ananantony/flora_mate/README.md

```
FloraMate
├─ 📁.mypy_cache
│  ├─ 📁3.14
│  │  ├─ 📁collections
│  │  │  ├─ 📄abc.data.json
│  │  │  ├─ 📄abc.meta.json
│  │  │  ├─ 📄__init__.data.json
│  │  │  └─ 📄__init__.meta.json
│  │  ├─ 📁email
│  │  │  ├─ 📄charset.data.json
│  │  │  ├─ 📄charset.meta.json
│  │  │  ├─ 📄contentmanager.data.json
│  │  │  ├─ 📄contentmanager.meta.json
│  │  │  ├─ 📄errors.data.json
│  │  │  ├─ 📄errors.meta.json
│  │  │  ├─ 📄header.data.json
│  │  │  ├─ 📄header.meta.json
│  │  │  ├─ 📄message.data.json
│  │  │  ├─ 📄message.meta.json
│  │  │  ├─ 📄policy.data.json
│  │  │  ├─ 📄policy.meta.json
│  │  │  ├─ 📄_policybase.data.json
│  │  │  ├─ 📄_policybase.meta.json
│  │  │  ├─ 📄__init__.data.json
│  │  │  └─ 📄__init__.meta.json
│  │  ├─ 📁importlib
│  │  │  ├─ 📁metadata
│  │  │  │  ├─ 📄_meta.data.json
│  │  │  │  ├─ 📄_meta.meta.json
│  │  │  │  ├─ 📄__init__.data.json
│  │  │  │  └─ 📄__init__.meta.json
│  │  │  ├─ 📁resources
│  │  │  │  ├─ 📄abc.data.json
│  │  │  │  ├─ 📄abc.meta.json
│  │  │  │  ├─ 📄_common.data.json
│  │  │  │  ├─ 📄_common.meta.json
│  │  │  │  ├─ 📄_functional.data.json
│  │  │  │  ├─ 📄_functional.meta.json
│  │  │  │  ├─ 📄__init__.data.json
│  │  │  │  └─ 📄__init__.meta.json
│  │  │  ├─ 📄abc.data.json
│  │  │  ├─ 📄abc.meta.json
│  │  │  ├─ 📄machinery.data.json
│  │  │  ├─ 📄machinery.meta.json
│  │  │  ├─ 📄readers.data.json
│  │  │  ├─ 📄readers.meta.json
│  │  │  ├─ 📄_abc.data.json
│  │  │  ├─ 📄_abc.meta.json
│  │  │  ├─ 📄_bootstrap.data.json
│  │  │  ├─ 📄_bootstrap.meta.json
│  │  │  ├─ 📄_bootstrap_external.data.json
│  │  │  ├─ 📄_bootstrap_external.meta.json
│  │  │  ├─ 📄__init__.data.json
│  │  │  └─ 📄__init__.meta.json
│  │  ├─ 📁json
│  │  │  ├─ 📄decoder.data.json
│  │  │  ├─ 📄decoder.meta.json
│  │  │  ├─ 📄encoder.data.json
│  │  │  ├─ 📄encoder.meta.json
│  │  │  ├─ 📄__init__.data.json
│  │  │  └─ 📄__init__.meta.json
│  │  ├─ 📁os
│  │  │  ├─ 📄path.data.json
│  │  │  ├─ 📄path.meta.json
│  │  │  ├─ 📄__init__.data.json
│  │  │  └─ 📄__init__.meta.json
│  │  ├─ 📁sys
│  │  │  ├─ 📄_monitoring.data.json
│  │  │  ├─ 📄_monitoring.meta.json
│  │  │  ├─ 📄__init__.data.json
│  │  │  └─ 📄__init__.meta.json
│  │  ├─ 📁zipfile
│  │  │  ├─ 📁_path
│  │  │  │  ├─ 📄__init__.data.json
│  │  │  │  └─ 📄__init__.meta.json
│  │  │  ├─ 📄__init__.data.json
│  │  │  └─ 📄__init__.meta.json
│  │  ├─ 📁_typeshed
│  │  │  ├─ 📄importlib.data.json
│  │  │  ├─ 📄importlib.meta.json
│  │  │  ├─ 📄__init__.data.json
│  │  │  └─ 📄__init__.meta.json
│  │  ├─ 📄@plugins_snapshot.json
│  │  ├─ 📄abc.data.json
│  │  ├─ 📄abc.meta.json
│  │  ├─ 📄ast.data.json
│  │  ├─ 📄ast.meta.json
│  │  ├─ 📄builtins.data.json
│  │  ├─ 📄builtins.meta.json
│  │  ├─ 📄codecs.data.json
│  │  ├─ 📄codecs.meta.json
│  │  ├─ 📄contextlib.data.json
│  │  ├─ 📄contextlib.meta.json
│  │  ├─ 📄dataclasses.data.json
│  │  ├─ 📄dataclasses.meta.json
│  │  ├─ 📄enum.data.json
│  │  ├─ 📄enum.meta.json
│  │  ├─ 📄fix_menu2.data.json
│  │  ├─ 📄fix_menu2.meta.json
│  │  ├─ 📄fix_menu_comments.data.json
│  │  ├─ 📄fix_menu_comments.meta.json
│  │  ├─ 📄genericpath.data.json
│  │  ├─ 📄genericpath.meta.json
│  │  ├─ 📄gen_kicad_footprint.data.json
│  │  ├─ 📄gen_kicad_footprint.meta.json
│  │  ├─ 📄gen_lceda_footprint.data.json
│  │  ├─ 📄gen_lceda_footprint.meta.json
│  │  ├─ 📄io.data.json
│  │  ├─ 📄io.meta.json
│  │  ├─ 📄ntpath.data.json
│  │  ├─ 📄ntpath.meta.json
│  │  ├─ 📄pathlib.data.json
│  │  ├─ 📄pathlib.meta.json
│  │  ├─ 📄posixpath.data.json
│  │  ├─ 📄posixpath.meta.json
│  │  ├─ 📄re.data.json
│  │  ├─ 📄re.meta.json
│  │  ├─ 📄sre_compile.data.json
│  │  ├─ 📄sre_compile.meta.json
│  │  ├─ 📄sre_constants.data.json
│  │  ├─ 📄sre_constants.meta.json
│  │  ├─ 📄sre_parse.data.json
│  │  ├─ 📄sre_parse.meta.json
│  │  ├─ 📄subprocess.data.json
│  │  ├─ 📄subprocess.meta.json
│  │  ├─ 📄types.data.json
│  │  ├─ 📄types.meta.json
│  │  ├─ 📄typing.data.json
│  │  ├─ 📄typing.meta.json
│  │  ├─ 📄typing_extensions.data.json
│  │  ├─ 📄typing_extensions.meta.json
│  │  ├─ 📄warnings.data.json
│  │  ├─ 📄warnings.meta.json
│  │  ├─ 📄_ast.data.json
│  │  ├─ 📄_ast.meta.json
│  │  ├─ 📄_codecs.data.json
│  │  ├─ 📄_codecs.meta.json
│  │  ├─ 📄_collections_abc.data.json
│  │  ├─ 📄_collections_abc.meta.json
│  │  ├─ 📄_frozen_importlib.data.json
│  │  ├─ 📄_frozen_importlib.meta.json
│  │  ├─ 📄_frozen_importlib_external.data.json
│  │  ├─ 📄_frozen_importlib_external.meta.json
│  │  ├─ 📄_io.data.json
│  │  ├─ 📄_io.meta.json
│  │  ├─ 📄_sitebuiltins.data.json
│  │  ├─ 📄_sitebuiltins.meta.json
│  │  ├─ 📄_tmp_write_doc.data.json
│  │  ├─ 📄_tmp_write_doc.meta.json
│  │  ├─ 📄_warnings.data.json
│  │  ├─ 📄_warnings.meta.json
│  │  ├─ 📄_winapi.data.json
│  │  ├─ 📄_winapi.meta.json
│  │  ├─ 📄_write_main_fsm.data.json
│  │  └─ 📄_write_main_fsm.meta.json
│  ├─ 📄.gitignore
│  └─ 📄CACHEDIR.TAG
├─ 📁.vscode
│  ├─ 📄launch.json
│  └─ 📄settings.json
├─ 📁code
│  ├─ 📁.settings
│  │  ├─ 📄language.settings.xml
│  │  ├─ 📄org.eclipse.core.resources.prefs
│  │  └─ 📄stm32cubeide.project.prefs
│  ├─ 📁.vscode
│  │  ├─ 📄c_cpp_properties.json
│  │  ├─ 📄launch.json
│  │  ├─ 📄settings.json
│  │  └─ 📄tasks.json
│  ├─ 📁App
│  │  ├─ 📁config
│  │  │  ├─ 📄app_config.c
│  │  │  └─ 📄app_config.h
│  │  ├─ 📁display
│  │  │  ├─ 📄app_display.c
│  │  │  └─ 📄app_display.h
│  │  ├─ 📁event
│  │  │  ├─ 📄app_event.c
│  │  │  └─ 📄app_event.h
│  │  ├─ 📁init
│  │  │  ├─ 📄app_init.c
│  │  │  └─ 📄app_init.h
│  │  ├─ 📁log
│  │  │  ├─ 📄app_log.c
│  │  │  ├─ 📄app_log.h
│  │  │  ├─ 📄app_log_ring_buffer.c
│  │  │  ├─ 📄app_log_ring_buffer.h
│  │  │  └─ 📄app_log_types.h
│  │  ├─ 📁main_fsm
│  │  │  ├─ 📄app_main_fsm.c
│  │  │  └─ 📄app_main_fsm.h
│  │  ├─ 📁manual_key
│  │  │  ├─ 📄app_manual_key.c
│  │  │  └─ 📄app_manual_key.h
│  │  ├─ 📁manual_select
│  │  │  ├─ 📄app_manual_select.c
│  │  │  └─ 📄app_manual_select.h
│  │  ├─ 📁menu
│  │  │  ├─ 📄app_menu.c
│  │  │  └─ 📄app_menu.h
│  │  ├─ 📁pump_fsm
│  │  │  ├─ 📄app_pump_fsm.c
│  │  │  └─ 📄app_pump_fsm.h
│  │  └─ 📁serial_debug
│  │     ├─ 📄app_serial_debug.c
│  │     ├─ 📄app_serial_debug.h
│  │     └─ 📄app_serial_debug_config.h
│  ├─ 📁Bsp
│  │  ├─ 📁eeprom
│  │  │  ├─ 📄bsp_eeprom.c
│  │  │  └─ 📄bsp_eeprom.h
│  │  ├─ 📁key
│  │  │  ├─ 📄bsp_key.c
│  │  │  └─ 📄bsp_key.h
│  │  ├─ 📁oled
│  │  │  ├─ 📄bsp_oled.c
│  │  │  ├─ 📄bsp_oled.h
│  │  │  ├─ 📄bsp_oled_config.h
│  │  │  └─ 📄bsp_oled_font.h
│  │  ├─ 📁pump_pwm
│  │  │  ├─ 📄bsp_pump_pwm.c
│  │  │  └─ 📄bsp_pump_pwm.h
│  │  ├─ 📁relay
│  │  │  ├─ 📄bsp_relay.c
│  │  │  └─ 📄bsp_relay.h
│  │  ├─ 📁tick
│  │  │  ├─ 📄bsp_tick.c
│  │  │  └─ 📄bsp_tick.h
│  │  ├─ 📁usart
│  │  │  ├─ 📄bsp_usart_log.c
│  │  │  └─ 📄bsp_usart_log.h
│  │  └─ 📁valve
│  │     ├─ 📄bsp_valve.c
│  │     └─ 📄bsp_valve.h
│  ├─ 📁build
│  ├─ 📁cmake
│  │  ├─ 📁stm32cubemx
│  │  │  └─ 📄CMakeLists.txt
│  │  ├─ 📄gcc-arm-none-eabi.cmake
│  │  └─ 📄starm-clang.cmake
│  ├─ 📁Common
│  │  ├─ 📁crc16
│  │  │  ├─ 📄crc16.c
│  │  │  └─ 📄crc16.h
│  │  ├─ 📁ring_buffer
│  │  │  ├─ 📄ring_buffer.c
│  │  │  └─ 📄ring_buffer.h
│  │  └─ 📁types
│  │     └─ 📄floramate_types.h
│  ├─ 📁Core
│  │  ├─ 📁Inc
│  │  │  ├─ 📄gpio.h
│  │  │  ├─ 📄i2c.h
│  │  │  ├─ 📄main.h
│  │  │  ├─ 📄stm32f4xx_hal_conf.h
│  │  │  ├─ 📄stm32f4xx_it.h
│  │  │  ├─ 📄tim.h
│  │  │  └─ 📄usart.h
│  │  ├─ 📁Src
│  │  │  ├─ 📄gpio.c
│  │  │  ├─ 📄i2c.c
│  │  │  ├─ 📄main.c
│  │  │  ├─ 📄stm32f4xx_hal_msp.c
│  │  │  ├─ 📄stm32f4xx_it.c
│  │  │  ├─ 📄syscalls.c
│  │  │  ├─ 📄sysmem.c
│  │  │  ├─ 📄system_stm32f4xx.c
│  │  │  ├─ 📄tim.c
│  │  │  └─ 📄usart.c
│  │  └─ 📁Startup
│  │     └─ 📄startup_stm32f401rctx.s
│  ├─ 📁Debug
│  ├─ 📁Drivers
│  │  ├─ 📁CMSIS
│  │  │  ├─ 📁Device
│  │  │  │  └─ 📁ST
│  │  │  │     └─ 📁STM32F4xx
│  │  │  │        ├─ 📁Include
│  │  │  │        │  ├─ 📄stm32f401xc.h
│  │  │  │        │  ├─ 📄stm32f4xx.h
│  │  │  │        │  └─ 📄system_stm32f4xx.h
│  │  │  │        ├─ 📁Source
│  │  │  │        │  └─ 📁Templates
│  │  │  │        └─ 📄LICENSE.txt
│  │  │  ├─ 📁Include
│  │  │  │  ├─ 📄cachel1_armv7.h
│  │  │  │  ├─ 📄cmsis_armcc.h
│  │  │  │  ├─ 📄cmsis_armclang.h
│  │  │  │  ├─ 📄cmsis_armclang_ltm.h
│  │  │  │  ├─ 📄cmsis_compiler.h
│  │  │  │  ├─ 📄cmsis_gcc.h
│  │  │  │  ├─ 📄cmsis_iccarm.h
│  │  │  │  ├─ 📄cmsis_version.h
│  │  │  │  ├─ 📄core_armv81mml.h
│  │  │  │  ├─ 📄core_armv8mbl.h
│  │  │  │  ├─ 📄core_armv8mml.h
│  │  │  │  ├─ 📄core_cm0.h
│  │  │  │  ├─ 📄core_cm0plus.h
│  │  │  │  ├─ 📄core_cm1.h
│  │  │  │  ├─ 📄core_cm23.h
│  │  │  │  ├─ 📄core_cm3.h
│  │  │  │  ├─ 📄core_cm33.h
│  │  │  │  ├─ 📄core_cm35p.h
│  │  │  │  ├─ 📄core_cm4.h
│  │  │  │  ├─ 📄core_cm55.h
│  │  │  │  ├─ 📄core_cm7.h
│  │  │  │  ├─ 📄core_cm85.h
│  │  │  │  ├─ 📄core_sc000.h
│  │  │  │  ├─ 📄core_sc300.h
│  │  │  │  ├─ 📄core_starmc1.h
│  │  │  │  ├─ 📄mpu_armv7.h
│  │  │  │  ├─ 📄mpu_armv8.h
│  │  │  │  ├─ 📄pac_armv81.h
│  │  │  │  ├─ 📄pmu_armv8.h
│  │  │  │  └─ 📄tz_context.h
│  │  │  └─ 📄LICENSE.txt
│  │  └─ 📁STM32F4xx_HAL_Driver
│  │     ├─ 📁Inc
│  │     │  ├─ 📁Legacy
│  │     │  │  └─ 📄stm32_hal_legacy.h
│  │     │  ├─ 📄stm32f4xx_hal.h
│  │     │  ├─ 📄stm32f4xx_hal_cortex.h
│  │     │  ├─ 📄stm32f4xx_hal_def.h
│  │     │  ├─ 📄stm32f4xx_hal_dma.h
│  │     │  ├─ 📄stm32f4xx_hal_dma_ex.h
│  │     │  ├─ 📄stm32f4xx_hal_exti.h
│  │     │  ├─ 📄stm32f4xx_hal_flash.h
│  │     │  ├─ 📄stm32f4xx_hal_flash_ex.h
│  │     │  ├─ 📄stm32f4xx_hal_flash_ramfunc.h
│  │     │  ├─ 📄stm32f4xx_hal_gpio.h
│  │     │  ├─ 📄stm32f4xx_hal_gpio_ex.h
│  │     │  ├─ 📄stm32f4xx_hal_i2c.h
│  │     │  ├─ 📄stm32f4xx_hal_i2c_ex.h
│  │     │  ├─ 📄stm32f4xx_hal_pwr.h
│  │     │  ├─ 📄stm32f4xx_hal_pwr_ex.h
│  │     │  ├─ 📄stm32f4xx_hal_rcc.h
│  │     │  ├─ 📄stm32f4xx_hal_rcc_ex.h
│  │     │  ├─ 📄stm32f4xx_hal_tim.h
│  │     │  ├─ 📄stm32f4xx_hal_tim_ex.h
│  │     │  ├─ 📄stm32f4xx_hal_uart.h
│  │     │  ├─ 📄stm32f4xx_ll_bus.h
│  │     │  ├─ 📄stm32f4xx_ll_cortex.h
│  │     │  ├─ 📄stm32f4xx_ll_dma.h
│  │     │  ├─ 📄stm32f4xx_ll_exti.h
│  │     │  ├─ 📄stm32f4xx_ll_gpio.h
│  │     │  ├─ 📄stm32f4xx_ll_i2c.h
│  │     │  ├─ 📄stm32f4xx_ll_pwr.h
│  │     │  ├─ 📄stm32f4xx_ll_rcc.h
│  │     │  ├─ 📄stm32f4xx_ll_system.h
│  │     │  ├─ 📄stm32f4xx_ll_tim.h
│  │     │  ├─ 📄stm32f4xx_ll_usart.h
│  │     │  └─ 📄stm32f4xx_ll_utils.h
│  │     ├─ 📁Src
│  │     │  ├─ 📄stm32f4xx_hal.c
│  │     │  ├─ 📄stm32f4xx_hal_cortex.c
│  │     │  ├─ 📄stm32f4xx_hal_dma.c
│  │     │  ├─ 📄stm32f4xx_hal_dma_ex.c
│  │     │  ├─ 📄stm32f4xx_hal_exti.c
│  │     │  ├─ 📄stm32f4xx_hal_flash.c
│  │     │  ├─ 📄stm32f4xx_hal_flash_ex.c
│  │     │  ├─ 📄stm32f4xx_hal_flash_ramfunc.c
│  │     │  ├─ 📄stm32f4xx_hal_gpio.c
│  │     │  ├─ 📄stm32f4xx_hal_i2c.c
│  │     │  ├─ 📄stm32f4xx_hal_i2c_ex.c
│  │     │  ├─ 📄stm32f4xx_hal_pwr.c
│  │     │  ├─ 📄stm32f4xx_hal_pwr_ex.c
│  │     │  ├─ 📄stm32f4xx_hal_rcc.c
│  │     │  ├─ 📄stm32f4xx_hal_rcc_ex.c
│  │     │  ├─ 📄stm32f4xx_hal_tim.c
│  │     │  ├─ 📄stm32f4xx_hal_tim_ex.c
│  │     │  └─ 📄stm32f4xx_hal_uart.c
│  │     └─ 📄LICENSE.txt
│  ├─ 📄.cproject
│  ├─ 📄.mxproject
│  ├─ 📄.project
│  ├─ 📄CMakeLists.txt
│  ├─ 📄CMakePresets.json
│  ├─ 📄FloraMate.ioc
│  ├─ 📄startup_stm32f401xc.s
│  ├─ 📄STM32F401RCTX_FLASH.ld
│  └─ 📄STM32F401XX_FLASH.ld
├─ 📁doc
│  ├─ 📁image
│  │  └─ 📁top板硬件设计方案
│  ├─ 📄FloraMate_V1.0_开发状态与测试指南.md
│  ├─ 📄STM32CubeMX_配置表_V1.0.md
│  ├─ 📄STM32CubeMX_配置表_V2.0_top板.md
│  ├─ 📄STM32_嵌入式_C语言编码风格手册.md
│  ├─ 📄top板硬件设计方案.md
│  ├─ 📄上电运行分支与操作逻辑_V1.1.md
│  ├─ 📄串口调试指令说明_V1.0.md
│  ├─ 📄总体设计书_V1.2.md
│  ├─ 📄硬件设计方案_V3.0.md
│  ├─ 📄软件设计方案_V1.0.md
│  └─ 📄配置项与存储映射_V1.0.md
├─ 📁file
│  ├─ 📁原理图
│  │  ├─ 📁_preview
│  │  │  ├─ 📄i2c2_full.png
│  │  │  ├─ 📄i2c2_pins_verify.png
│  │  │  ├─ 📄i2c_right.png
│  │  │  ├─ 📄keys_mcu.png
│  │  │  ├─ 📄led.png
│  │  │  ├─ 📄left_cmd.png
│  │  │  ├─ 📄mcu_full.png
│  │  │  ├─ 📄pb_pins.png
│  │  │  └─ 📄u1_i2c.png
│  │  └─ 📄SCH_Schematic1_2026-08-25.pdf
│  ├─ 📁存储
│  │  ├─ 📄bea42f4d4459f7d05e09dc1cf551c215.png
│  │  ├─ 📄型号.txt
│  │  └─ 📄存储模块.pdf
│  ├─ 📁屏幕
│  │  ├─ 📁1.3寸OLED裸屏资料
│  │  │  ├─ 📄SH1106 V2.3.pdf
│  │  │  └─ 📄SPEC QG-2864KSWLG01 VER A.pdf
│  │  └─ 📄README.md
│  ├─ 📁屏幕和按键
│  │  └─ 📁0.96寸OLED+4个按键-资料
│  │     └─ 📁0.96寸OLED+4个按键-资料
│  │        └─ 📁程序
│  │           └─ 📁（02）STM32例程(STM32F103C8T6)
│  │              └─ 📁I2C_SSD1306_STM32(HW)
│  │                 ├─ 📁Output
│  │                 └─ 📁Project
│  │                    └─ 📁RVMDK(uV4)
│  ├─ 📁按键
│  │  └─ 📄6932d3898fc3f6578d4f2fed5f337dba.jpg
│  ├─ 📁控制器
│  │  ├─ 📁STM32F4x1数据手册
│  │  │  └─ 📁STM32F4x1数据手册
│  │  │     ├─ 📄DS9716_STM32F401xB和STM32F401xC datasheet单片机的数据手册.pdf
│  │  │     ├─ 📄RM0368_STM32F401xBC和STM32F401xDE Reference manual单片机参考手册.pdf
│  │  │     └─ 📄STM32F401RCT6_DATASHEET.pdf
│  │  ├─ 📁STM32F4x1核心板-封装尺寸结构图
│  │  │  └─ 📁STM32F4x1核心板-封装尺寸结构图
│  │  │     ├─ 📁__Previews
│  │  │     │  ├─ 📄STM32F401RCT6开发板-尺寸图.pcbdocPreview
│  │  │     │  └─ 📄STM32F4x1-尺寸图.PcbDocPreview
│  │  │     ├─ 📄STM32F401RCT6开发板-尺寸图.jpg
│  │  │     └─ 📄STM32F401RCT6开发板-尺寸图.pcbdoc
│  │  ├─ 📄STM32F401RCT6开发板-原理图.pdf
│  │  ├─ 📄STM32F401RCT6开发板引脚分配.pdf
│  │  ├─ 📄STM32F4x1数据手册.rar
│  │  └─ 📄STM32F4x1核心板-封装尺寸结构图.rar
│  ├─ 📁电磁阀
│  │  └─ 📄b7ab4d8e5c5d89b31135ef5318c395e3.jpg
│  ├─ 📁继电器
│  │  ├─ 📄1431bfeb1a24a31f9118de0c2538e350.jpg
│  │  └─ 📄参数.txt
│  ├─ 📁调速
│  │  ├─ 📄36328bdf4b52b8c419efc9c0c6e27270.png
│  │  └─ 📄型号.txt
│  ├─ 📄FloraMate.pdf
│  ├─ 📄FloraMate_PCB.pdf
│  └─ 📄STM32F401RCT6开发板-尺寸图.jpg
├─ 📄.clang-format
├─ 📄.gitattributes
└─ 📄.gitignore
```
