ananantony/flora_mate/doc/FloraMate_V1.0_开发状态与测试指南.md

# FloraMate V1.0 — 开发状态与测试实践指南

> 文档版本：1.1.0 · 日期：2026-09-10 · 作者：tonymeng  
> **HMI V2.0 更新（2026-09-10）：** 产品路径已改为 Logo → Idle → 主界面 / 自动浇水。操作与手测清单以 [`上电运行分支与操作逻辑_V2.0.md`](上电运行分支与操作逻辑_V2.0.md) 为准；下文 §2~§4 部分描述仍为 V1.0 架构，已标注差异处。

---

## 一、整体架构速览

```
┌─────────────────────────────────────────────────────────────┐
│ App 层（业务逻辑）                                            │
│  app_init  app_main_fsm  app_pump_fsm  app_menu             │
│  app_display  app_config  app_event  app_log                │
├─────────────────────────────────────────────────────────────┤
│ BSP 层（板级抽象）                                            │
│  bsp_tick  bsp_usart_log  bsp_valve  bsp_pump_pwm           │
│  bsp_key   bsp_oled       bsp_eeprom                        │
├─────────────────────────────────────────────────────────────┤
│ Common（公共库）                                              │
│  ring_buffer   crc16   floramate_types                      │
├─────────────────────────────────────────────────────────────┤
│ HAL / CMSIS（STM32CubeMX 生成，不手动修改）                   │
└─────────────────────────────────────────────────────────────┘
```

MCU：STM32F401RCT6 @ 84 MHz，256 KB Flash，64 KB SRAM，LQFP64

---

## 二、已开发完成功能清单

### 2.1 BSP 层

| 模块 | 文件 | 实现内容 | 状态 |
|---|---|---|---|
| **时基** | `bsp_tick.c/h` | SysTick 1 ms 基准；`GetMs` / `ElapsedMs` / `DelayMs` | ✅ 完成 |
| **USART 日志** | `bsp_usart_log.c/h` | USART1 115200 8N1；非阻塞环形缓冲 TX；`TxFlush` 中断推进 | ✅ 完成 |
| **阀门** | `bsp_valve.c/h` | 5 路阀 Z1~Z5（PA1~PA5）AO4407A P-MOS 高边，高电平有效；干转互锁判定 `AnyOn`；逐路自检 | ✅ 完成 |
| **水泵 PWM** | `bsp_pump_pwm.c/h` | TIM2-CH1（PA0）100 Hz，1000 级分辨率；`SetDutyPercent` / `Stop`；duty>0 需任一阀已开 | ✅ 完成 |
| **按键** | `bsp_key.c/h` | 4 键（**Top V2.0：K1~K4 = PC0~PC3**）消抖 20 ms；短按 / 长按 / 超长按阈值可配；事件回调注入 | ✅ 完成 |
| **OLED** | `bsp_oled.c/h` + `bsp_oled_font.h` | 1.3" 128×64 SSD1306/1315 I2C；6×8 + 16×16 字模 | ✅ 完成 |
| **EEPROM** | `bsp_eeprom.c/h` | AT24C08C I2C（1 KB，16 B/页）；字节 / 页随机读写；在线探测 `IsOnline` | ✅ 完成 |

### 2.2 Common 层

| 模块 | 文件 | 实现内容 | 状态 |
|---|---|---|---|
| **环形缓冲** | `ring_buffer.c/h` | 通用 FIFO，字节级读写，非线程安全（供 UART TX 使用） | ✅ 完成 |
| **CRC-16** | `crc16.c/h` | CRC-16-CCITT（多项式 0x1021，初值 0xFFFF）；`Compute` + `Update` | ✅ 完成 |
| **类型定义** | `floramate_types.h` | `Fm_ErrorCode` 错误码枚举；`Fm_ValveIndex`；版本宏；硬限常量 | ✅ 完成 |

### 2.3 App 层

| 模块 | 文件 | 实现内容 | 状态 |
|---|---|---|---|
| **日志** | `app_log.c/h` + `app_log_ring_buffer.c/h` + `app_log_types.h` | MPSC 环形缓冲；6 级过滤（FATAL–VERBOSE）；紧急模式直传；限速宏；异步 UART 消费 | ✅ 完成 |
| **事件队列** | `app_event.c/h` | 8 槽 FIFO；`PostKey` 回调（供 BSP 按键调用）；`Pop`；`APP_EVENT_KEY_*` 枚举（SHORT / LONG / HOLD） | ✅ 完成 |
| **配置存储** | `app_config.c/h` | AT24C08C 双 Bank 轮换（仅配置，日志不入 EEPROM）；Bank header + payload 各一 CRC-16；版本管理；`SetField` / `GetField` / `Dump` / `FactoryReset` | ✅ 完成 |
| **显示调度** | `app_display.c/h` | 100 ms 节流；按主 FSM 切换页面（**LOGO / IDLE / AUTO_RUN / MENU / SERIAL_DEBUG / DONE / ERROR**） | ✅ V2.0 |
| **产品菜单** | `app_menu.c/h` | **V2.0：** 主界面 2 项、设置 3 项、本地测试 3 项、参数单项保存；K1–K4 完整映射 | ✅ V2.0 |
| **主状态机** | `app_main_fsm.c/h` | **V2.0：** LOGO → IDLE(5s) → AUTO_RUN / MENU / SERIAL_DEBUG → DONE / ERROR；K4 紧急停；心跳 LED | ✅ V2.0 |
| **水泵子 FSM** | `app_pump_fsm.c/h` | 单路 9 态 FSM：IDLE → INIT → OPEN_MAIN → STEP（8 档）→ RAMP_DOWN → CLOSE_MAIN → CLOSE_VALVE → GAP → DONE / ERROR；PWM 阶梯执行 | ✅ 完成 |
| **应用装配** | `app_init.c/h` | `App_Init`（6 步顺序初始化）+ `App_Loop`（永不返回主循环） | ✅ 完成 |

---

## 三、暂未开发 / 预留功能清单

### 3.1 V1.0 代码中已有占位但逻辑未实现

| 功能 | 预留位置 | 说明 |
|---|---|---|
| **AUTO_RUN 中跳过当前路（K1）** | `app_main_fsm.c:343` | `LOG_INFO("auto run: SKIP zone (K1) -- not implemented in V1.0")` 仅记录日志 |
| **AUTO_RUN 中暂停（K2）** | `app_main_fsm.c:347` | 同上；`App_Pump_Fsm_Pause/Resume` 函数已声明但未实现实际状态挂起 |
| **单路超时软检测** | `app_main_fsm.c:244-245` | 注释说明已预留注入点，目前靠总任务超时（600 s）兜底 |
| **SLEEP 状态低功耗** | `app_main_fsm.c:287-289` | 状态机进入后永久驻留，未调用 `__WFI` / Stop 模式 |
| **菜单周期逻辑** | `app_menu.c:App_Menu_Tick` | 函数体中只有预留注释，无超时返回等实际逻辑 |
| **备用阀 Z5（PA5）** | `bsp_valve.h: BSP_VALVE_Z5` | 通道已定义并可驱动，业务层暂作备用（与 Z1~Z4 等价） |

### 3.2 V2.x 规划中的扩展功能

| 功能 | 优先级 | 说明 |
|---|---|---|
| **看门狗（IWDG）** | 高 | 错误码 `FM_ERR_020_WATCHDOG` 已占位；需在 `App_Loop` 内定期喂狗 |
| **串口命令行（CLI）** | 已完成 | `app_serial_debug`：Idle 5s 或设置→Serial Test 进调试；`AUTO_ENTER` 宏可上电直进调试 |
| **定时自动浇灌** | 中 | 需外挂 RTC（MCU 内置 RTC 或外置 DS3231）+ 配置时间表；EEPROM 预留空间足够 |
| **单路超时精细控制** | 低 | 目前靠总超时兜底；可在子 FSM Tick 内加 `per_channel_timeout_s` 判断 |
| **水流传感器** | 低 | 架构支持，硬件未焊接；可接预留 GPIO 外部中断计脉冲（注意避开已用引脚） |
| **蓝牙 / WiFi 远程** | 低 | 预留 USART2 / SPI2 外扩模块；需增加通信适配层 |
| **日志持久化** | 低 | **AT24C08C 仅 1 KB，只存配置；日志在 RAM（易失）。** 如需掉电保留历史须换更大容量存储后再规划 |

---

## 四、测试流程指南

### 4.1 硬件首次上电检查清单

```
□ 确认 3.3 V / 5 V 双电源正常，无异常发热
□ ST-Link 连接成功，STM32CubeIDE Debug 模式下单步走 App_Init 前半段
□ OLED 显示 Logo（SW/HW 版本行）→ Idle 5s 倒计时
□ USART1（PA9 TX = 115200 8N1）收到日志：
    [xxx][I][FloraMate] [App_Init,...] ==== FloraMate V1.0 ====
    [xxx][I][FloraMate] [App_Init,...] init done. eeprom=1 oled=1
    [xxx][I][FloraMate] sys fsm: init LOGO
□ Idle 期间串口每秒 `[I] hb ... wait_remain_ms=...`；进入调试后无心跳
□ Idle 发 `debug` → OLED 显示命令与 OK/ERR，串口打印 help
□ 不按键、Idle 超时后进入 AUTO_RUN 自动浇灌
□ 心跳 LED（Top 板原理图 PC12；当前 Cube 配置见 Core/Inc/main.h）~500 ms 闪烁
```

### 4.2 BSP 单模块验证

#### 4.2.1 电磁阀（P-MOS 高边）

```
测试方法：进入串口调试态（上电后发送 `debug`）
操作：`valve open 1`~`5` 逐路测 Z1~Z5（PA1~PA5）
验证：
  □ 对应阀通电出水 / 指示灯变化（LED 灭 = 阀开，LED 亮 = 阀关）
  □ 用万用表量 VALVEx_OUT_P（P-MOS 漏极）：阀开≈12V，阀关≈0V
  □ OLED 显示阀号和 ON/OFF 状态
  □ 串口无 I2C 错误日志
退出时验证全部阀 OFF（发送 `stop` 或 `valve close`）
```

#### 4.2.2 水泵 PWM

```
测试方法：进入串口调试态后用阀和泵命令联调
推荐步骤：
  1. `valve open 1`（任一路阀，满足干转互锁）
  2. `pump 30`，再按需 `pump 50` / `pump 80`（实际夹到 ≤95%）
  3. 用示波器或逻辑分析仪测量 PA0 波形：
     □ 频率 100 Hz（±1%）
     □ 占空比与 OLED 显示一致
  4. 无阀打开时发 `pump 30` 应被拒绝，返回 `FM_ERR_013_PUMP_NO_POWER`
  5. `pump off`，验证 PWM 归零（停泵）
```

#### 4.2.3 OLED

```
在 IDLE 倒计时页观察：
  □ 倒计时数字每秒递减（使用 16×16 大字模）
  □ 屏幕无撕裂 / 残影
  □ 调整菜单中的 oled_contrast 参数，保存后对比度变化
```

#### 4.2.4 按键

```
  □ LOGO / IDLE / SERIAL_DEBUG 下菜单键无效（`App_Main_Fsm_KeyInputEnabled`）
  □ `valve open 1` + `valve open 2` 可同时 on；`valve close` 全部释放
恢复菜单/自动流程后再按原 IDLE / DONE / ERROR 映射验证按键
```

#### 4.2.5 EEPROM

```
验证步骤：
  1. 进入菜单 → 参数列表，将某个参数改为非默认值（如 step_count=3）
  2. 长按 K3 保存 → 日志出现 "config saved to bank X"
  3. 断电 → 重新上电
  4. 进入菜单验证修改已持久化
  5. 工厂复位页长按 K4（3 s）确认 → 验证参数恢复默认值
  6. 串口确认 "factory reset done"
```

### 4.3 系统级端到端测试

#### 4.3.1 标准浇灌流程（V2.0 产品路径）

```
前提：至少 channel_enable bit0 = 1（Z1 开启），step_count ≥ 1，step_duty[0] > 0
步骤：
  1. 上电 → Logo → 等待 Idle 5s 倒计时结束（或 Idle 期间 K1+K3 2s 进主界面后选 Auto Water）
  2. 观察 AUTO_RUN 进度：
     □ OLED 显示 "Zone 1 / Step X / Duty Y%"
     □ 当前路阀 Z_i 先开，约 200 ms 后水泵 PWM 起调
     □ PWM 按配置阶梯输出
  3. 单路完成后观察：
     □ PWM 先 RAMP_DOWN → 停泵（PWM=0）→ 关阀 → 路间静默
     □ 继续下一路（若已使能）
  4. 全部完成后：
     □ 进入 DONE 页（"All Done!"），**K4 回主界面**
     □ 所有阀确认为 OFF 状态（万用表/目视指示灯）
```

#### 4.3.2 紧急停止测试（V2.0）

```
步骤：AUTO_RUN 进行中 → 按 K4（短按/长按均可）
验证：
  □ 日志 "auto run: STOPPED by K4"
  □ 所有阀立即 OFF（App_Pump_Fsm_Abort）
  □ 系统进入 DONE（Stopped），再按 K4 回主界面
  □ 水流在 < 500 ms 内停止（阀门响应时间）
```

#### 4.3.3 超时保护测试

```
方法：将 total_timeout_s 设置为极小值（如 5 s）
步骤：开始自动浇灌 → 不干预 → 等待 5 s
验证：
  □ 日志出现 "auto run: TOTAL timeout (5s)"
  □ 系统进入 ERROR 状态
  □ 所有阀 OFF，心跳 LED 快速闪烁（100 ms）
  □ OLED 显示错误码
```

#### 4.3.4 EEPROM 掉电安全测试

```
步骤：
  1. 开始保存配置时（长按 K3），立即断电
  2. 重新上电，观察配置是否完好
原理：双 Bank 写入先 payload 后 header；
     断在 payload 写入中途 → 该 Bank header 未更新，回退到旧 Bank；
     断在 header 写入中途 → CRC 校验失败，回退到旧 Bank。
预期：任何断电时机均不会丢失上一次成功保存的配置。
```

### 4.4 串口调试方法

连接 USART1（PA9，115200 8N1），使用 SecureCRT / MobaXterm / VSCode Serial Monitor：

```
观察启动序列（关键日志示例）：
[0][I][FloraMate] [App_Init,...] ==== FloraMate V1.0 ====
[1][I][FloraMate] [App_Config_Init,...] config loaded from bank A (seq=3)
[2][I][FloraMate] [App_Init,...] init done. eeprom=1 oled=1
[3][I][FloraMate] sys fsm: init LOGO
[I] hb uptime_ms=1000 wait_remain_ms=4000
debug
[I] serial debug active (no hb)
```

调整日志等级（菜单 log_level 参数）：
- `0` = ERROR 只看报错
- `1` = WARN  推荐日常调试
- `2` = INFO  查看状态转移（默认）
- `3` = DEBUG 查看 FSM 每步细节

常用命令见 `串口调试指令说明_V1.0.md`。最小联调序列：

```text
debug
status
valve open 1
pump 30
pump off
valve close
```

---

## 五、后续开发优先级建议

### 阶段 1（硬件验证期，本周）

```
1. 完成 § 4.1 ~ § 4.3 所有硬件验证项
2. 记录并修复实测中发现的参数不合理（阀门开合时序、PWM 阶梯时间）
3. 确认 EEPROM 双 Bank 切换正常（§ 4.2.5 + § 4.3.4）
```

### 阶段 2（功能完善，2~3 周）

```
4. 实现看门狗（IWDG）
   - App_Loop 每轮喂狗
   - 配置超时约 2 s（主循环空载 < 200 μs，有充足余量）

5. 恢复/完善自动运行入口
   - 需要长期停在调试态时，将 `APP_SERIAL_DEBUG_AUTO_ENTER_ON_BOOT` 置 1 重新编译

6. 实现单路超时精细检测
   - 在 App_Main_Fsm_Tick 的 AUTO_RUN case 内，对当前运行路
     增加 per_channel_timeout_s 判断并记录错误码
```

### 阶段 3（可选增强）

```
7. 日志持久化（需先换更大容量存储）
   - 当前 AT24C08C 仅 1 KB 且只存配置，**日志保持在 RAM（易失）**
   - 如需掉电保留历史，改用 AT24C32/64 或 SPI Flash 后再划日志区

8. RTC + 定时浇灌
   - 接入 MCU 内置 RTC（无需外接晶振，F401 内置 RC 精度够用）
   - 在 EEPROM 中增加 schedule[7] 数组（每天时刻 + 使能位）
   - App_Main_Fsm 在 SLEEP 态周期唤醒比对 RTC

9. 暂停 / 继续功能
   - App_Pump_Fsm_Pause：保存 step_idx，PWM 降为 0（停泵），保持当前阀
   - App_Pump_Fsm_Resume：恢复 PWM + 剩余时间继续
```

---

## 六、已知约束与注意事项

| 约束 | 说明 |
|---|---|
| **浇灌期间不可断电** | V1.0 无断电续浇逻辑；若中途断电，重启后会重新从第一路开始 |
| **EEPROM 寿命** | AT24C08C 典型写寿命 1,000,000 次；双 Bank + `update_count` 统计；仅低频配置写入，寿命非瓶颈 |
| **看门狗未启用** | V1.0 无 IWDG；软件死锁时需手动断电复位，**待阶段 2 修复** |
| **Idle 5s 串口窗** | Logo 后 Idle 5s 内可发 `debug`；超时自动浇水；Idle 期间 K1+K3 2s 进主界面；`AUTO_ENTER=1` 可常开调试 |
| **备用阀 Z5（PA5）** | 通道已定义并可驱动，业务层暂未编排（与 Z1~Z4 等价） |
| **K4 紧急停止** | AUTO_RUN 期间 K4 立即停止并进入 DONE(Stopped) |
| **SLEEP 已移除** | V2.0 产品路径无 SLEEP 态；完成页等待 K4 回主界面 |
| **单路最大占空比 95%** | `FM_PUMP_DUTY_MAX_PERCENT = 95`，硬限，不允许 100%（过热保护） |
| **总任务硬限 600 s** | `FM_TOTAL_TASK_HARD_LIMIT_S = 600`，代码层不允许 EEPROM 配置覆盖 |

---

*文档由 AI 辅助生成，基于代码实际实现状态；如需更新请同步修改本文件。*
