ananantony/flora_mate/doc/top板硬件设计方案.md

基于最新提交的完整原理图（图纸名称：FloraMate V1.0 / Schematic1），本方案剥离所有 PCB 走线和物理布局内容，聚焦于**电路拓扑、电气特性、信号流向、参数计算依据以及 MCU 每个引脚的具体硬件映射与功能定义**。

### **一、 电源管理与供电切换子系统**

Plaintext  
 \[Type-C USB1\] ──► 5V\_USB ──► \[BAT54C D1 Pin1 (A1)\] ┐  
                                                     ├─► 5V\_MAIN ──► \[AMS1117-3.3 U3\] ──► 3V3 主电源网  
 \[2×10Pin U1\]  ──► \+5V\_CLEAN ─► \[BAT54C D1 Pin2 (A2)\] ┘                │  
                                                                       ▼  
                                                       \[C8: 10µF \+ C9: 100nF (输入滤波)\]  
                                                       \[C10: 100nF \+ C11: 10µF (输出滤波)\]

#### **1\. 双路电源 OR-ing 无缝切换电路**

* **核心器件**：D1 (BAT54C) SOT-23 共阴极双肖特基二极管。  
* **引脚与流向**：  
  * **Pin 1 (阳极 A1)**：接入 Type-C 接口输出的 5V\_USB 节点。  
  * **Pin 2 (阳极 A2)**：接入 2×10Pin 接口 Pin 1 传入的外部净化电源 \+5V\_CLEAN。  
  * **Pin 3 (公共阴极 K)**：输出汇聚节点 5V\_MAIN。  
* **工作逻辑与电气参数**：  
  * **自动接管**：肖特基二极管正向导通压降极低（$V\_{\\text{F}} \\approx 0.32\\text{V} @ 50\\text{mA}$），两路 5V 谁电压略高即由谁自动向后级供电。  
  * **防倒灌保护**：两颗单向导电管阻断反向回路，杜绝插上 USB 调试时向外部动力板倒灌，同时防止下板动力反串损坏 PC 端 USB 接口。

#### **2\. LDO 线性稳压与阶梯式滤波电路**

* **核心器件**：U3 (AMS1117-3.3) SOT-223 封装固定输出稳压器。  
* **输入级滤波**：5V\_MAIN 进入 Pin 3 (VIN) 前，并联 **C8 (10µF MLCC)** 吸收低频纹波 \+ **C9 (100nF MLCC)** 滤除高频瞬态毛刺。  
* **输出级稳压**：Pin 2 / Pin 4 (VOUT) 输出 3V3 电平，并联 **C10 (100nF)** \+ **C11 (10µF)**。  
* **压差计算裕量**：  
  $$V\_{\\text{IN\\\_LDO}} \= 5.0\\text{V} \- V\_{\\text{F(BAT54C)}} \\approx 4.68\\text{V}$$  
  $$\\Delta V \= 4.68\\text{V} \- 3.3\\text{V} \= 1.38\\text{V} \> V\_{\\text{dropout(max)}} (1.1\\text{V})$$  
  保证 LDO 在全负载工况下均稳定工作在稳压线性区。

### **二、 USB-UART 通信与 ESD 接口子系统**

#### **1\. Type-C 受电接口（USB1）**

* **位号/型号**：USB1 (TYPE-C 16PIN 2MD/073)。  
* **CC 逻辑配置**：CC1 (Pin A5) 与 CC2 (Pin B5) 分别通过 **R22 (5.1kΩ)** 与 **R18 (5.1kΩ)** 独立下拉至 ISO\_GND。  
  * **原理**：通知供电端（Source/PC/PD充电头）本机为标准 UFP（受电下行设备），请求开启默认 5V VBUS 供电。  
* **外壳与屏蔽**：外壳固定脚（EH）直连 ISO\_GND，提供静电泄放通路。

#### **2\. 瞬态静电防护（D2: USBLC6-2SC6）**

* **拓扑结构**：  
  * **Pin 1 (I/O1)** 接 Type-C Dp1/Dp2，**Pin 6 (I/O1)** 输出 USB\_D+。  
  * **Pin 3 (I/O2)** 接 Type-C Dn1/Dn2，**Pin 4 (I/O2)** 输出 USB\_D-。  
  * **Pin 5 (VBUS)** 接 5V\_USB，**Pin 2 (GND)** 接 ISO\_GND。  
* **原理**：将 USB 数据线与电源线的超压静电尖峰双向钳位至 $V\_{\\text{BUS}} \+ V\_{\\text{F}}$ 与 $\\text{GND} \- V\_{\\text{F}}$，极低结电容（$\< 0.8\\text{pF}$）确保 USB 全速信号不失真。

#### **3\. USB 转串口芯片（U4: CH340C）**

* **供电与退耦**：  
  * Pin 16 (VCC) 接入 3V3，配置 **C17 (100nF)** 退耦电容。  
  * Pin 4 (V3) 内部 LDO 节点直接短接至 3V3（在 3.3V 供电标准下必须短接 VCC 与 V3）。  
* **信号连接**：  
  * Pin 5 (D+) 与 Pin 6 (D-) 分别接入经过 ESD 芯片后的 USB\_D+ 与 USB\_D-。  
  * Pin 2 (TXD) 输出 USART1\_RX 信号，Pin 3 (RXD) 输入 USART1\_TX 信号，直连 MCU 串口。

### **三、 人机交互、存储与板间接口子系统**

#### **1\. 硬件 RC 消抖按键电路（KEY1）**

* **接口**：5-Pin 插件端子（Pin 1 为公共 ISO\_GND，Pin 2\~5 分别为 K1\~K4 按键输入）。  
* **4 路独立对称滤波网络**（以 K1 为例）：  
  * **串联限流防冲**：K1 输入端串联 **R19 (100Ω)** 抑制机械触点打火与 ESD。  
  * **电平偏置**：节点通过 **R29 (10kΩ)** 上拉至 3V3，静态保持高电平。  
  * **硬件积分消抖**：并联 **C21 (100nF)** 到 ISO\_GND。  
  * **时间常数**：$\\tau \= R \\times C \= 10\\text{k}\\Omega \\times 100\\text{nF} \= 1\\text{ms}$，滤除按键动作产生的 $5\\sim 10\\text{ms}$ 机械弹跳毛刺。  
* **其他通道映射**：  
  * K2 $\\to$ R20 (100Ω) \+ R30 (10kΩ) \+ C22 (100nF)  
  * K3 $\\to$ R21 (100Ω) \+ R28 (10kΩ) \+ C20 (100nF)  
  * K4 $\\to$ R23 (100Ω) \+ R31 (10kΩ) \+ C23 (100nF)

#### **2\. I²C 总线拓扑与非易失存储（I2C1 域）**

* **总线上拉**：I2C1\_SCL 与 I2C1\_SDA 分别配置 **R6 (4.7kΩ)** 与 **R7 (4.7kΩ)** 上拉至 3V3。  
* **EEPROM 存储器（U10: AT24C08C）**：  
  * 供电端 Pin 8 (VCC) 配置 **C18 (100nF)** 滤波。  
  * 地址选择 Pin 1\~3 (E0, E1, E2) 与写保护 Pin 7 (WC\#) 均接地 ISO\_GND，器件固定硬件物理地址，处于全程允许读写状态。  
  * Pin 6 (SCL) 与 Pin 5 (SDA) 挂载至 I2C1 总线，用于掉电持久化保存运行参数。  
* **显示接口（OLED1）**：  
  * 4-Pin 接口直出 3V3、ISO\_GND、I2C1\_SCL、I2C1\_SDA，驱动 0.96 寸 OLED 显示屏。

#### **3\. 双板互联总线（U1: 2×10Pin 2.54mm 排针）**

用于控制信号向底层功率驱动板下发以及状态信号回传：

* **Pin 1**：+5V\_CLEAN（隔离电源输入正极）  
* **Pin 3, 5, 7, 9, 11**：VALVE1\_CMD \~ VALVE4\_CMD、PUMP\_CMD 动力驱动信号  
* **Pin 8, 10, 12**：VALVE2\_CMD、VALVE3\_CMD、VALVE5\_CMD 动力驱动信号  
* **Pin 15, 16**：I2C2\_SCL、I2C2\_SDA（隔离数字测量总线，预留给底层功率计）  
* **Pin 2, 4, 6, 13, 14, 17, 18**：多点直通 ISO\_GND，为各路控制信号提供就近的回流屏蔽

### **四、 主控 MCU（U2: STM32F401RCT6）引脚硬件级映射方案**

MCU 采用 LQFP-64 封装，工作核心主频 84MHz，内置 256KB Flash 与 64KB SRAM。下表详述当前原理图上**全部 64 个物理引脚的硬件连接、网络名称、外设复用与电气配置**：

| 引脚编号 | 引脚物理原生名称 | 原理图网络名称 (Net Name) | 外设功能映射 | 外围硬件电路详细说明 |
| :---- | :---- | :---- | :---- | :---- |
| **1** | VBAT | 3V3 | 备用电池供电 | 经 **R3 (0Ω 跳线)** 直连板载 3V3，维持内部 RTC 与后备寄存器供电。 |
| **2** | PC13-ANTI\_TAMP | PC13 | GPIO 输入 | 悬空预留，可作为低功耗侵入检测或用户备用 GPIO。 |
| **3** | PC14-OSC32\_IN | PC14 | GPIO / LSE 输入 | 悬空预留，未焊接 32.768kHz 低速晶振。 |
| **4** | PC15-OSC32\_OUT | PC15 | GPIO / LSE 输出 | 悬空预留，未焊接 32.768kHz 低速晶振。 |
| **5** | PH0-OSC\_IN | PH0-OSC\_IN | HSE 时钟输入 | 直连 25MHz 晶振 **X2** 一端，并联 **C12 (15pF C0G)** 负载电容到地。 |
| **6** | PH1-OSC\_OUT | PH1-OSC\_OUT | HSE 时钟输出 | 直连 25MHz 晶振 **X2** 另一端，并联 **C13 (15pF C0G)** 负载电容到地。 |
| **7** | NRST | NRST | 系统异步复位 | 连接 **R24 (10kΩ)** 上拉至 3.3V，并联 **C14 (100nF)** 消抖电容，引至 SWD1 排针。 |
| **8** | PC0 | PC0 | GPIO 输入 (按键) | 接入 **K1** 按键滤波输出节点（R19+R29+C21 滤波后信号）。 |
| **9** | PC1 | PC1 | GPIO 输入 (按键) | 接入 **K2** 按键滤波输出节点（R20+R30+C22 滤波后信号）。 |
| **10** | PC2 | PC2 | GPIO 输入 (按键) | 接入 **K3** 按键滤波输出节点（R21+R28+C20 滤波后信号）。 |
| **11** | PC3 | PC3 | GPIO 输入 (按键) | 接入 **K4** 按键滤波输出节点（R23+R31+C23 滤波后信号）。 |
| **12** | VSSA / VREF- | ISO\_GND | 模拟地基准 | 直连整板隔离地 ISO\_GND。 |
| **13** | VDDA / VREF+ | 3V3 | 模拟电源基准 | 直连 3V3，配置 **C7 (100nF)** 独立高频退耦电容。 |
| **14** | PA0-WKUP | PA0 | TIM2\_CH1 / GPIO | 串接 **R1 (510Ω)** 限流电阻，输出 PUMP\_CMD 水泵控制信号至 U1。 |
| **15** | PA1 | PA1 | TIM2\_CH2 / GPIO | 串接 **R2 (510Ω)** 限流电阻，输出 VALVE1\_CMD 电磁阀1控制信号至 U1。 |
| **16** | PA2 | PA2 | TIM2\_CH3 / GPIO | 串接 **R4 (510Ω)** 限流电阻，输出 VALVE2\_CMD 电磁阀2控制信号至 U1。 |
| **17** | PA3 | PA3 | TIM2\_CH4 / GPIO | 串接 **R5 (510Ω)** 限流电阻，输出 VALVE3\_CMD 电磁阀3控制信号至 U1。 |
| **18** | VSS\_1 | ISO\_GND | 数字地 1 | 芯片就地连接主地平面 ISO\_GND。 |
| **19** | VDD\_1 | 3V3 | 数字电源 1 | 接入 3V3，就近配置 **C1 (100nF)** 退耦电容。 |
| **20** | PA4 | PA4 | GPIO 输出 | 串接 **R10 (510Ω)** 限流电阻，输出 VALVE4\_CMD 电磁阀4控制信号至 U1。 |
| **21** | PA5 | PA5 | GPIO 输出 | 串接 **R11 (510Ω)** 限流电阻，输出 VALVE5\_CMD 电磁阀5控制信号至 U1。 |
| **22** | PA6 | PA6 | GPIO / ADC | 悬空预留，可配置为通用输入输出或模拟采样。 |
| **23** | PA7 | PA7 | GPIO / ADC | 悬空预留，可配置为通用输入输出或模拟采样。 |
| **24** | PC4 | PC4 | GPIO / ADC | 悬空预留。 |
| **25** | PC5 | PC5 | GPIO / ADC | 悬空预留。 |
| **26** | PB0 | PB0 | GPIO / TIM3\_CH3 | 悬空预留。 |
| **27** | PB1 | PB1 | GPIO / TIM3\_CH4 | 悬空预留。 |
| **28** | PB2 | PB2 / BOOT1 | GPIO / BOOT1 | 悬空预留，内部默认下拉。 |
| **29** | PB10 | I2C2\_SCL | I2C2\_SCL | 串接 **R13 (100Ω)** 阻抗匹配电阻，输出 I2C2\_SCL 至 U1 Pin15；挂载 **R8 (4.7kΩ)** 上拉至 3.3V。 |
| **30** | VCAP\_1 | VCAP1 | 内部 1.2V LDO 稳压输出 | 外接 **C15 (4.7µF MLCC)** 极低 ESR 储能电容到 ISO\_GND（**禁止接任何电源**）。 |
| **31** | VSS\_2 | ISO\_GND | 数字地 2 | 芯片就地连接主地平面 ISO\_GND。 |
| **32** | VDD\_2 | 3V3 | 数字电源 2 | 接入 3V3，就近配置 **C2 (100nF)** 退耦电容。 |
| **33** | PB12 | I2C2\_SDA | I2C2\_SDA | 串接 **R17 (100Ω)** 阻抗匹配电阻，输出 I2C2\_SDA 至 U1 Pin16；挂载 **R9 (4.7kΩ)** 上拉至 3.3V。 |
| **34** | PB13 | PB13 | SPI2\_SCK / GPIO | 悬空预留。 |
| **35** | PB14 | PB14 | SPI2\_MISO / GPIO | 悬空预留。 |
| **36** | PB15 | PB15 | SPI2\_MOSI / GPIO | 悬空预留。 |
| **37** | PC6 | PC6 | TIM3\_CH1 / GPIO | 悬空预留。 |
| **38** | PC7 | PC7 | TIM3\_CH2 / GPIO | 悬空预留。 |
| **39** | PC8 | PC8 | TIM3\_CH3 / GPIO | 悬空预留。 |
| **40** | PC9 | PC9 | TIM3\_CH4 / GPIO | 悬空预留。 |
| **41** | PA8 | PA8 | MCO1 / GPIO | 悬空预留，可作为主时钟输出测试点。 |
| **42** | PA9 | USART1\_TX | USART1\_TX | 串接 **R12 (1kΩ)** 保护电阻，连接至 CH340C 的 RXD (Pin 3\) 进行串口发送。 |
| **43** | PA10 | USART1\_RX | USART1\_RX | 串接 **R15 (1kΩ)** 保护电阻，连接至 CH340C 的 TXD (Pin 2\) 进行串口接收。 |
| **44** | PA11 | PA11 | USB\_DM / GPIO | 经 **R14 (10kΩ)** 下拉至 ISO\_GND（禁用 MCU 片上原生 USB 物理层）。 |
| **45** | PA12 | PA12 | USB\_DP / GPIO | 经 **R16 (10kΩ)** 下拉至 ISO\_GND（禁用 MCU 片上原生 USB 物理层）。 |
| **46** | PA13 | SWDIO | JTMS-SWDIO | 直连调试端子 **SWD1 Pin 2**，用于 SWD 双向数据烧录与调试。 |
| **47** | VSS\_3 | ISO\_GND | 数字地 3 | 芯片就地连接主地平面 ISO\_GND。 |
| **48** | VDD\_3 | 3V3 | 数字电源 3 | 接入 3V3，就近配置 **C3 (100nF)** 退耦电容。 |
| **49** | PA14 | SWCLK | JTCK-SWCLK | 直连调试端子 **SWD1 Pin 3**，用于 SWD 时钟同步。 |
| **50** | PA15 | PA15 | JTDI / GPIO | 悬空预留。 |
| **51** | PC10 | PC10 | UART4\_TX / GPIO | 悬空预留。 |
| **52** | PC11 | PC11 | UART4\_RX / GPIO | 悬空预留。 |
| **53** | PC12 | PC12 | GPIO 输出 (指示灯) | 连接 **LED1 (蓝色发光管)** 阴极，阳极经 **R20 (470Ω)** 接 3.3V，低电平点亮。（**注意**：本文档沿用功能名 LED1=PC12 心跳灯，对应原理图位号 **LED2 / R20**，阻值已由 4.7kΩ 改为 470Ω。） |
| **54** | PD2 | PD2 | TIM3\_ETR / GPIO | 悬空预留。 |
| **55** | PB3 | PB3 | JTDO / TRACESWO | 悬空预留。 |
| **56** | PB4 | PB4 | NJTRST / GPIO | 悬空预留。 |
| **57** | PB5 | PB5 | GPIO / I2C1\_SMBA | 悬空预留。 |
| **58** | PB6 | I2C1\_SCL | I2C1\_SCL | 挂载 **R6 (4.7kΩ)** 上拉至 3.3V，直连 U10 EEPROM 与 OLED1 屏幕的 SCL。 |
| **59** | PB7 | I2C1\_SDA | I2C1\_SDA | 挂载 **R7 (4.7kΩ)** 上拉至 3.3V，直连 U10 EEPROM 与 OLED1 屏幕的 SDA。 |
| **60** | BOOT0 | BOOT0 | 启动模式选择 | 经 **R25 (10kΩ)** 下拉至 ISO\_GND，锁定系统上电默认从用户 Flash 启动。 |
| **61** | PB8 | PB8 | TIM4\_CH3 / GPIO | 悬空预留。 |
| **62** | PB9 | PB9 | TIM4\_CH4 / GPIO | 悬空预留（芯片原生 I2C2\_SDA 复用脚，本板未用）。 |
| **63** | VSS\_4 | ISO\_GND | 数字地 4 | 芯片就地连接主地平面 ISO\_GND。 |
| **64** | VDD\_4 | 3V3 | 数字电源 4 | 接入 3V3，就近配置 **C4 (100nF)** 退耦电容。 |

> **⚠️ 已知硬件设计问题 — I2C2 引脚复用不匹配（按原理图网络名记录，暂不改线）**
>
> | 原理图网络 | 实际走线引脚 | 芯片 AF4 功能 | 结论 |
> |---|---|---|---|
> | I2C2_SCL | **PB10** (Pin 29) | **I2C2_SCL** | ✅ 正确，可用硬件 I2C2 SCL |
> | I2C2_SDA | **PB12** (Pin 33) | **I2C2_SMBA**（非 SDA） | ❌ 无法作为硬件 I2C2_SDA |
> | — | PB9 (Pin 62，未走线) | **I2C2_SDA** | 改板建议：SDA 改接 PB9 |
>
> 固件/CubeMX 策略：**PB10 = I2C2_SCL（硬件）**；**PB12 = GPIO 开漏软件 bit-bang SDA**（Label: `I2C2_SDA_BB`）。详见 `STM32CubeMX_配置表_V2.0_top板.md` § 6.6。
>
> **其余业务引脚复用核对（2026-08-25）**：PA0~PA5、PA9/PA10、PB6/PB7、PC0~PC3、PC12、PH0/PH1 均与 STM32F401RCT6 数据手册 AF 表一致，**无其他冲突**。

### **五、 关键阻容参数设计依据与电路保护机理**

> 1. **串口引脚隔离保护阻抗（R12, R15: 1kΩ）**：  
   * 在 MCU (PA9/PA10) 与 CH340C (RXD/TXD) 之间串入 1kΩ 电阻。  
   * **作用**：当 USB 未插电（CH340C 断电）而系统由外部供电运行时，MCU 串口引脚输出的高电平不会通过 CH340C 内部 ESD 保护二极管形成电流倒灌，避免 CH340C 处于微弱“假带电”异常悬浮状态。  
> 2. **片上 USB 物理引脚下拉锁定（R14, R16: 10kΩ）**：  
   * 将未使用的 PA11 (DM) 与 PA12 (DP) 引脚通过 10kΩ 电阻下拉接地。  
   * **作用**：防止引脚悬空在高频环境下捕获静电天线效应触发 MCU 内部 USB 外设中断或产生浮空漏电流。  
> 3. **输出控制线限流缓冲（R1, R2, R4, R5, R10, R11: 510Ω）**：  
   * 串联在 PA0\~PA5 控制输出口与 U1 端子之间。  
   * **作用**：为下层驱动板的光耦输入端发光二极管（如 TLP281）提供精准的前向工作电流限流：  
     $$I\_{\\text{F}} \= \\frac{V\_{\\text{OH}} \- V\_{\\text{F(opto)}}}{R} \= \\frac{3.3\\text{V} \- 1.2\\text{V}}{510\\Omega} \\approx 4.12\\text{mA}$$  
     既保证光耦深饱和导通，又避免单片机 GPIO 超负荷发热。  
> 4. **内部稳压电容配置（C15: 4.7µF X7R）**：  
   * 跨接在 Pin 30 ($V\_{\\text{CAP\\\_1}}$) 与地之间。  
   * **作用**：STM32F4 内部 1.2V 调压器（供电给 Cortex-M4 内核、锁相环 PLL 及数字外设）的稳定补偿电容。4.7µF 容量与极低 ESR 抑制了 PLL 高频倍频切换时的瞬态下陷，保障 84MHz 满频下的运行稳定性。  
> 5. **指示灯限流电阻（原理图位号 R1、R20：470Ω；对应本文档功能名 LED1/LED2）**：  
>   * **电源指示灯（原理图 LED1）**：3V3 → R1 (470Ω) → LED1 → ISO_GND，上电恒亮，指示系统供电正常。  
>   * **心跳灯（原理图 LED2，本文档称 LED1）**：3V3 → R20 (470Ω) → LED2 → PC12，低电平点亮，由固件周期翻转。  
>   * **作用**：LED 型号 GL0805UB01（0805 蓝色，Vf=2.6~3.1V，额定 20mA），取 Vf≈3.0V 时：  
>     $$I_{\text{LED}} = \frac{3.3\text{V} - 3.0\text{V}}{470\Omega} \approx 0.64\text{mA}$$  
>     该电流仅为额定值的 3%，但已保证肉眼清晰可见；同时避免 1kΩ/4.7kΩ 旧值下 LED 近乎不可见（<0.3mA/64µA）的问题。470Ω 下电阻功耗 <1mW，对 3V3 电源与 GPIO 灌电流均无压力。  
> 6. **位号体系说明**：本方案文档采用"功能位号"（R1/R2/R4/R5/R10/R11 等），与原理图 EDA 自动编号（如 510Ω 输出限流为原理图 R14~R19）**不一致**。电路评审/改板时请以**原理图位号**为准，对应关系：功能 R1/R2/R4/R5/R10/R11(510Ω) = 原理图 R14~R19；心跳灯限流 = 原理图 R20(470Ω)；电源指示灯限流 = 原理图 R1(470Ω)；USART1 保护 = 原理图 R22/R23(1kΩ)。
