ananantony/flora_mate/file/控制器/STM32F4x1核心板-封装尺寸结构图/STM32F4x1核心板-封装尺寸结构图/STM32F401RCT6开发板-尺寸图.jpg

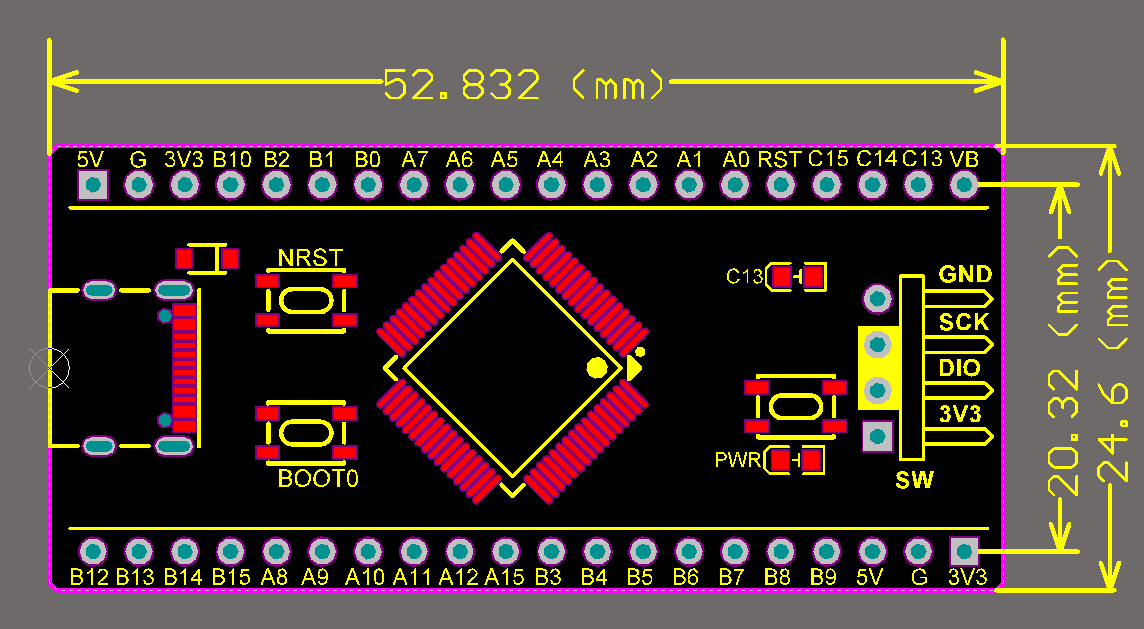
file/控制器/STM32F4x1核心板-封装尺寸结构图/STM32F4x1核心板-封装尺寸结构图/STM32F401RCT6开发板-尺寸图.jpg
