ananantony/flora_mate/file/电磁阀/b7ab4d8e5c5d89b31135ef5318c395e3.jpg

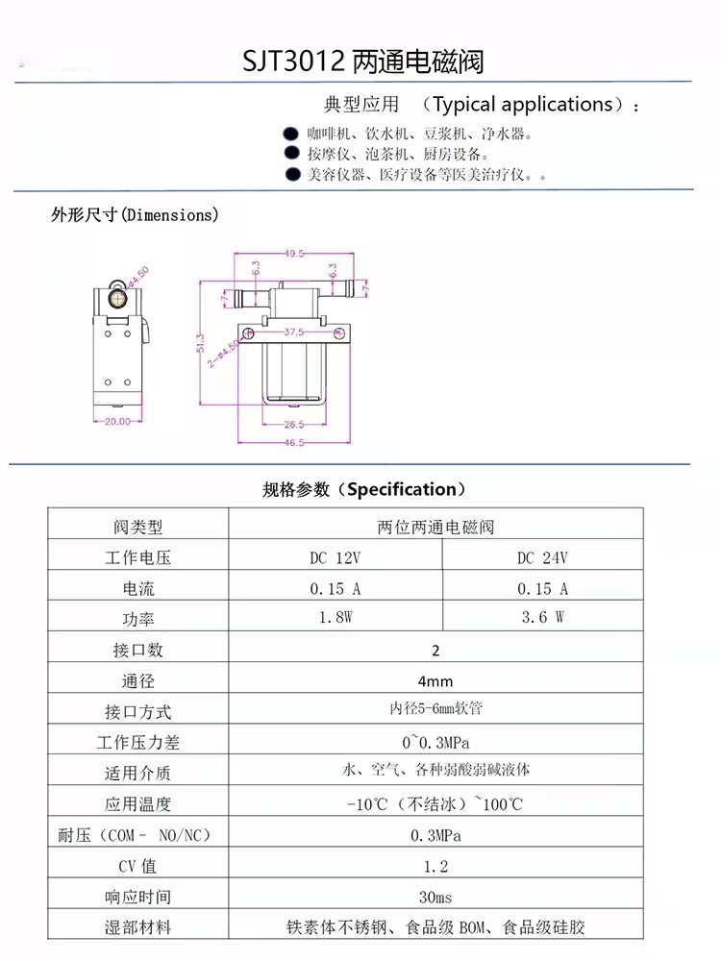
file/电磁阀/b7ab4d8e5c5d89b31135ef5318c395e3.jpg
