ananantony/flora_mate/file/原理图/top/top.pdf

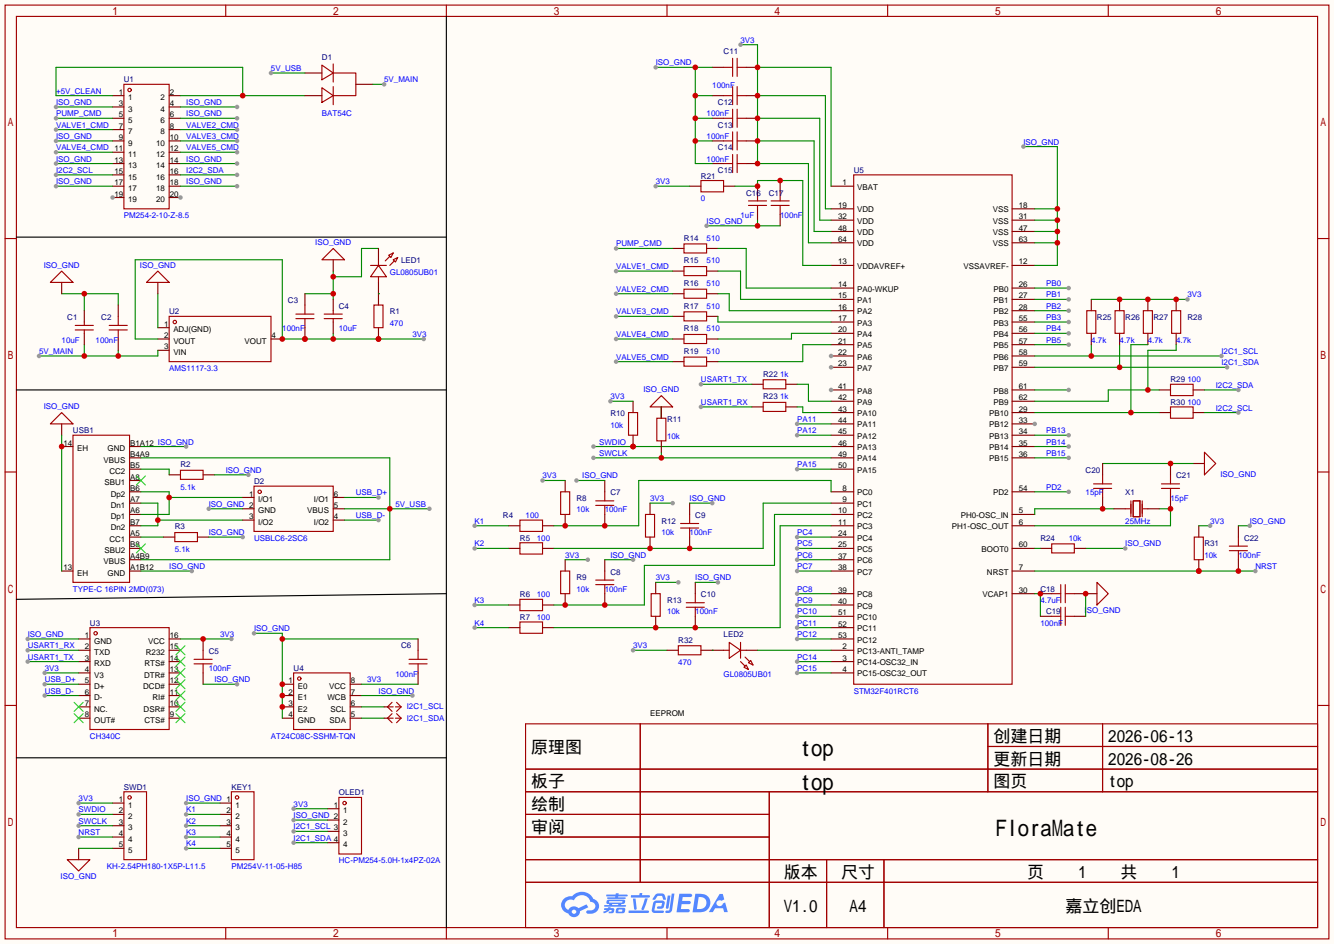
[picture p3: page 1]

USB1
GND A1B12 VBUS A4B9 SBU2 B8 CC1 A5 Dn2 B7 Dp1 A6 Dn1 A7 Dp2 B6 SBU1 A8 CC2 B5 VBUS B4A9 GND B1A12 EH 14

原理图 | top | 创建日期 | 2026-06-13

更新日期 | 2026-08-26

板子 | top | 图页 | top
绘制 | | FloraMate
审阅

V1.0 | A4 | 嘉立创EDA
