ananantony/flora_mate/file/控制器/STM32F401RCT6开发板-原理图.pdf

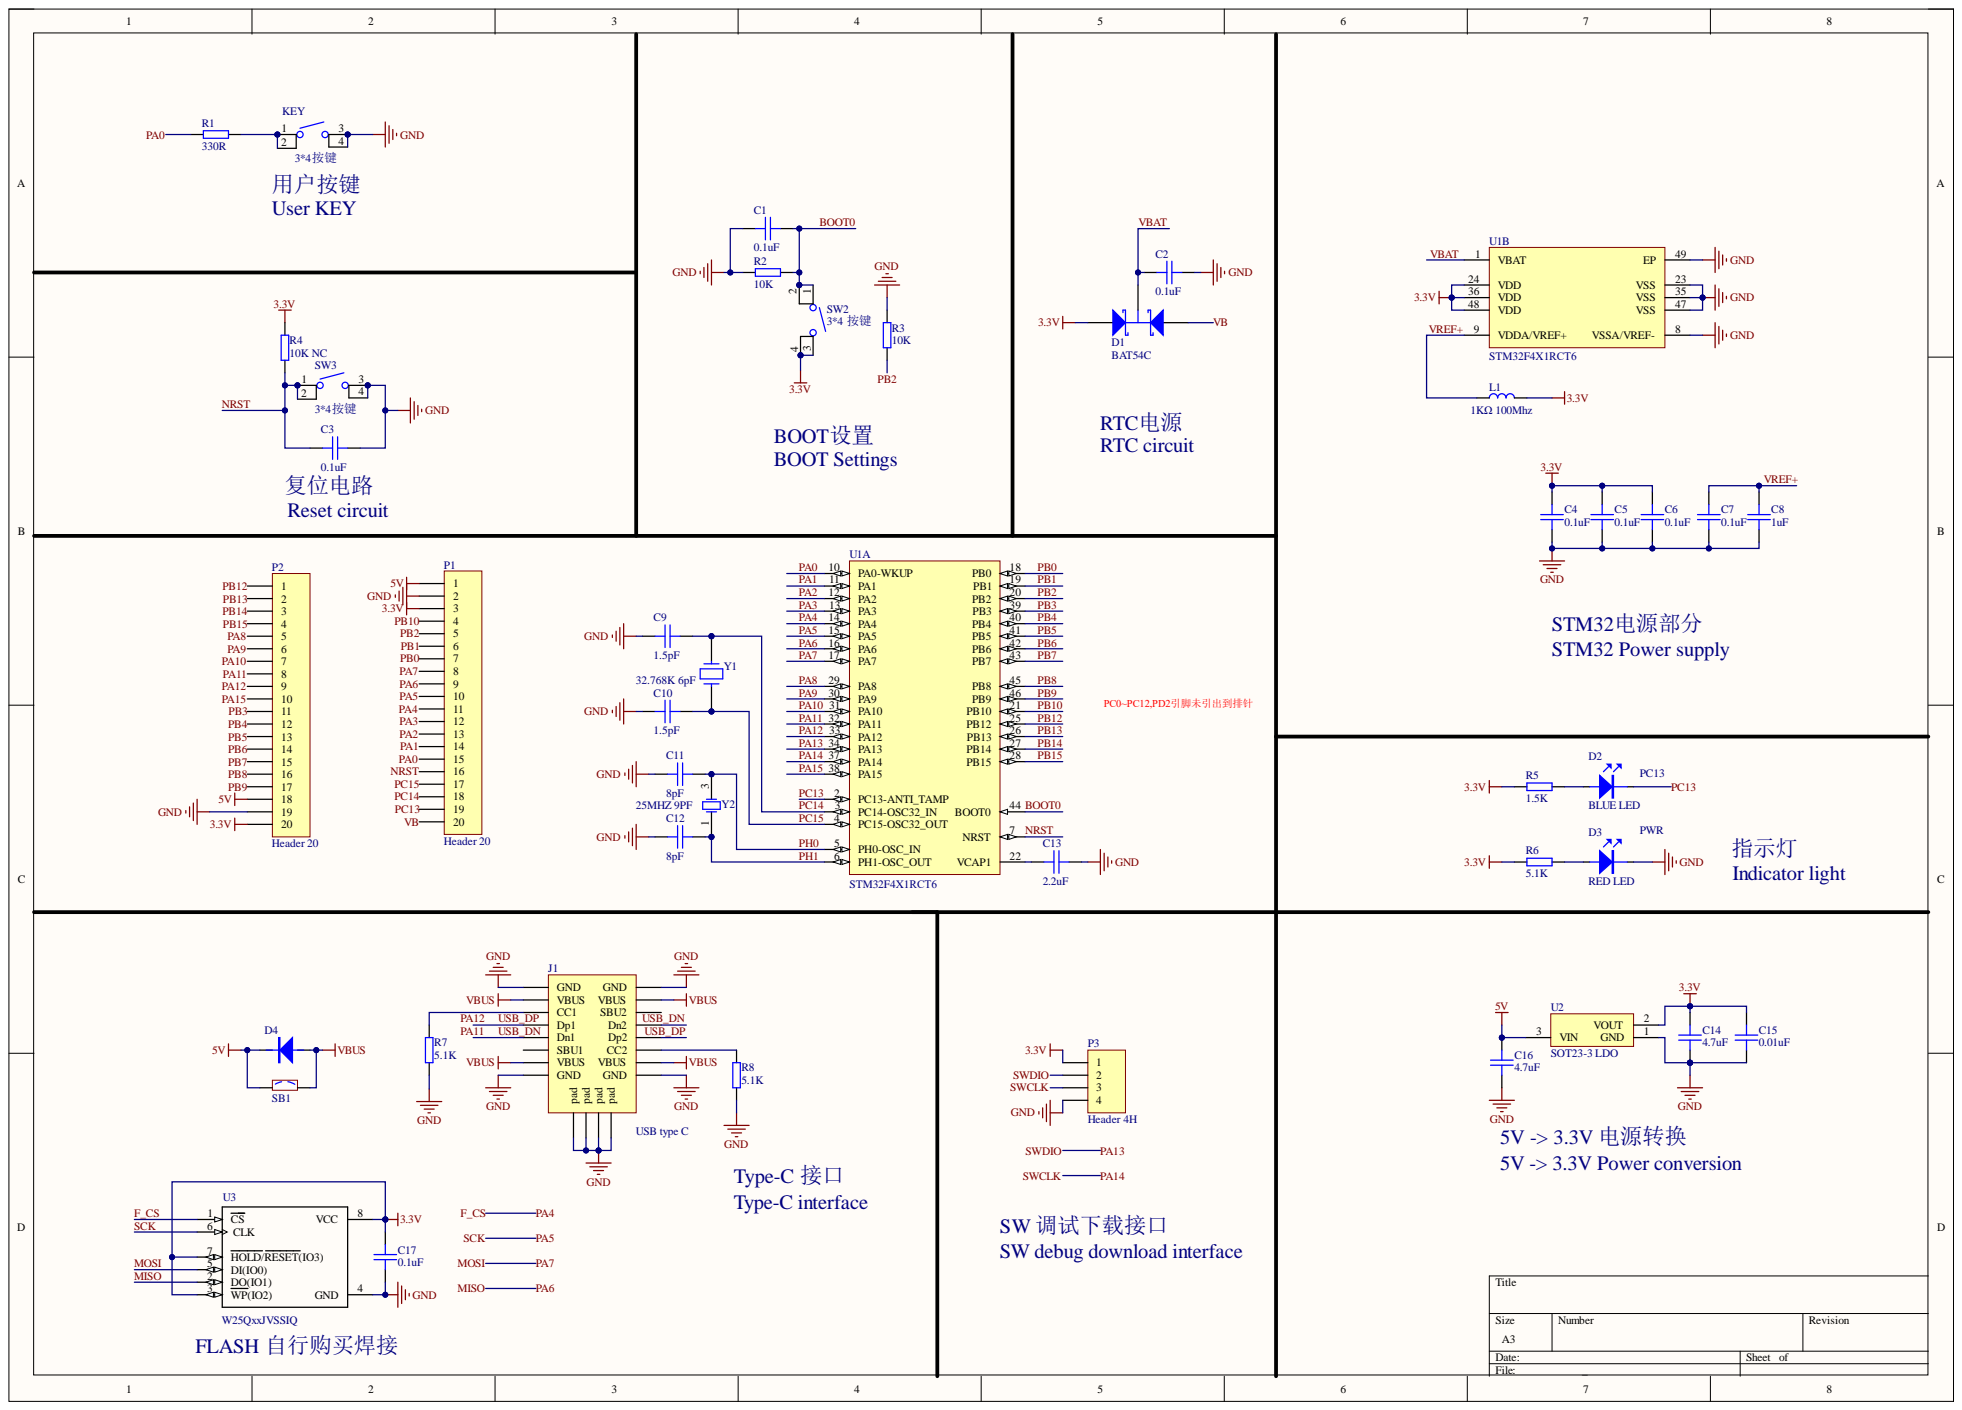
[picture p4: page 1]

PH1-OSC_OUT 6

SW 调试下载接口
SW debug download interface
