ananantony/flora_mate/file/原理图/bottom/bottom_0828.pdf

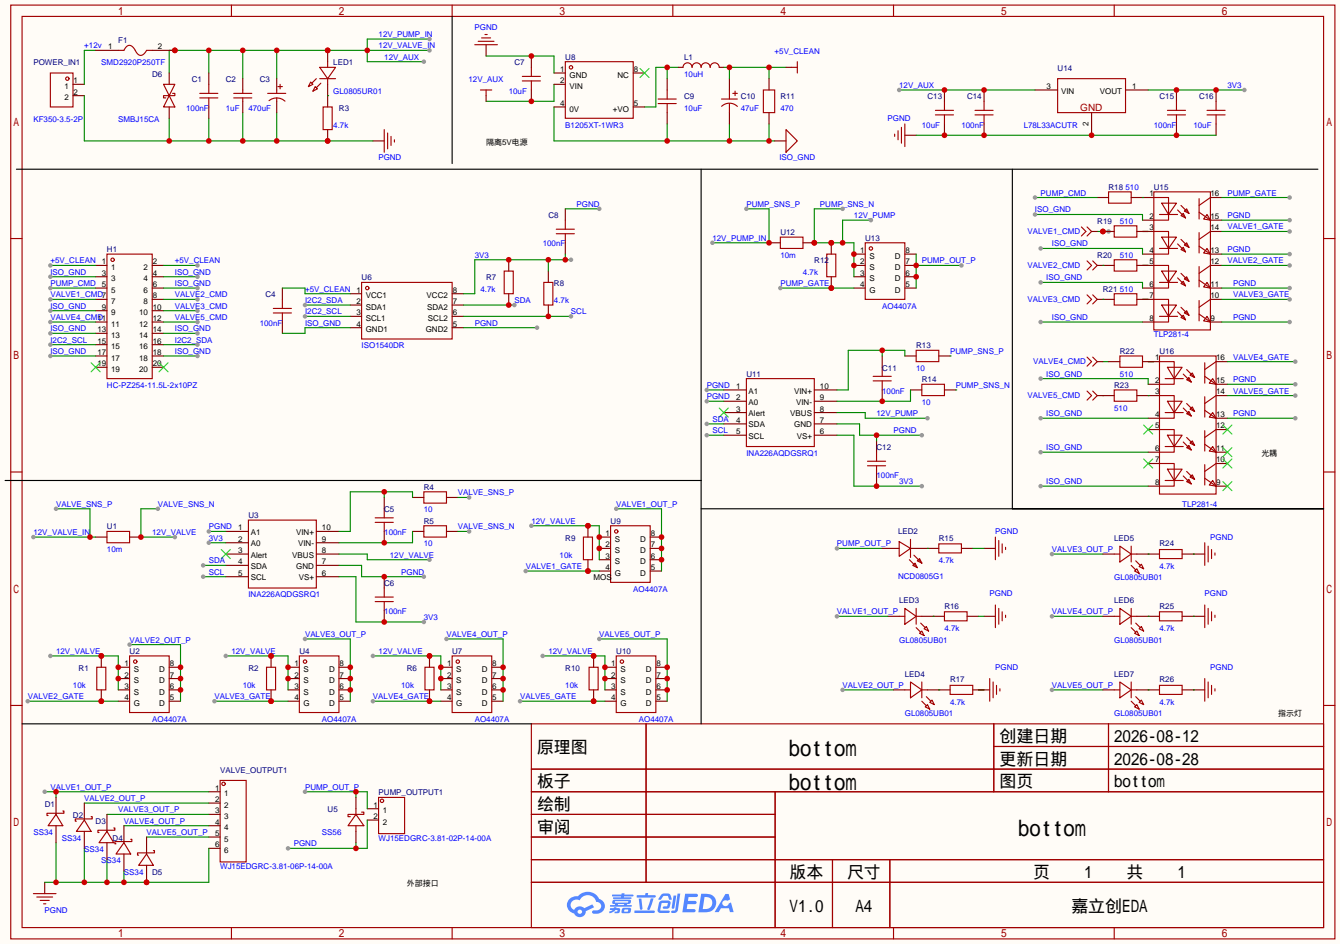
[picture p5: page 1]

更新日期 | 2026-08-28

板子 | bottom | 图页 | bottom
绘制 | | bottom
审阅

V1.0 | A4 | 嘉立创EDA
