ananantony/flora_mate/(list of files, drawings)

Other design files:
file/控制器/STM32F4x1核心板-封装尺寸结构图/STM32F4x1核心板-封装尺寸结构图/STM32F401RCT6开发板-尺寸图.pcbdoc
