ananantony/flora_mate/Core/Src/main.c

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
/* Includes ------------------------------------------------------------------*/
#include "main.h"
#include "i2c.h"
#include "tim.h"
#include "usart.h"
#include "gpio.h"

/* USER CODE BEGIN Includes */
/** 焊板首测：1 = 仅 PC13 心跳 LED 500 ms 闪烁；正式功能测试完成后改 0 并重新编译 */
#define FM_BOARD_BRINGUP_LED_ONLY  (0)
#define FM_BRINGUP_LED_PERIOD_MS   (500U)
#if !FM_BOARD_BRINGUP_LED_ONLY
#include "app_init.h"
#endif
/* USER CODE END Includes */


void SystemClock_Config(void);
/**
  * @brief  The application entry point.
  * @retval int
  */
int main(void)
{

  /* MCU Configuration--------------------------------------------------------*/

  /* Reset of all peripherals, Initializes the Flash interface and the Systick. */
  HAL_Init();

  /* Configure the system clock */
  SystemClock_Config();

  /* Initialize all configured peripherals */
  MX_GPIO_Init();
  MX_I2C1_Init();
  MX_USART1_UART_Init();
  MX_TIM2_Init();
  /* USER CODE BEGIN 2 */
#if FM_BOARD_BRINGUP_LED_ONLY
  /* 首测模式：MX_GPIO_Init 已将 PC13(LED) 置 High(灭)，低电平点亮 */
#else
  App_Init();
#endif
  /* USER CODE END 2 */

  /* Infinite loop */
  /* USER CODE BEGIN WHILE */
#if FM_BOARD_BRINGUP_LED_ONLY
  while (1)
  {
    HAL_GPIO_TogglePin(LED_HEARTBEAT_GPIO_Port, LED_HEARTBEAT_Pin);
    HAL_UART_Transmit(&huart1, (uint8_t *)"hello world\r\n", 13, HAL_MAX_DELAY);
    HAL_Delay(FM_BRINGUP_LED_PERIOD_MS);
  }
#else
  App_Loop();
#endif
  while (1)
  {
    /* USER CODE END WHILE */

    /* USER CODE BEGIN 3 */
  }
  /* USER CODE END 3 */
}

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
