ananantony/flora_mate/Bsp/oled/bsp_oled_font.h

/*
 * @File         : \code\Bsp\oled\bsp_oled_font.h
 * @Author       : tonymeng
 * @Date         : 2026-05-15 11:30:00
 * @LastEditors  : tonymeng0910@gmail.com
 * @LastEditTime : 2026-05-15 14:50:00
 * @Description  : OLED 字模数据（内部头，仅 bsp_oled.c 包含）
 *                 - 6×8 ASCII：每字符 6 B，列扫描，LSB 在最上方；
 *                 - 16×16 大数字：每字符 32 B（每列 2 B × 16 列）。
 *
 * Copyright (c) 2026 by tony.meng, All Rights Reserved.
 *
 *   _________________________________________________________________________
 *  | Date       | Version | Author      |  Description                       |
 *  |=========================================================================|
 *  |            |         |             |                                    |
 *  |-------------------------------------------------------------------------|
 *  |            |         |             |                                    |
 *  |-------------------------------------------------------------------------|
 */
#ifndef BSP_OLED_FONT_INTERNAL_H
#define BSP_OLED_FONT_INTERNAL_H

#include <stdint.h>

/* ------------------------------------------------------------------
 * 6×8 ASCII 字模（0x20 空格 ~ 0x7E '~'，95 个字符）
 * 每字符 6 字节；每个字节代表 8 个垂直像素，LSB 在最上方。
 * ------------------------------------------------------------------ */
static const uint8_t g_font_6x8[][6] = {
    {0x00, 0x00, 0x00, 0x00, 0x00, 0x00}, /* 0x20 SPACE */
    {0x00, 0x00, 0x5F, 0x00, 0x00, 0x00}, /* 0x21 ! */
    {0x00, 0x07, 0x00, 0x07, 0x00, 0x00}, /* 0x22 " */
    {0x14, 0x7F, 0x14, 0x7F, 0x14, 0x00}, /* 0x23 # */
    {0x24, 0x2A, 0x7F, 0x2A, 0x12, 0x00}, /* 0x24 $ */
    {0x23, 0x13, 0x08, 0x64, 0x62, 0x00}, /* 0x25 % */
    {0x36, 0x49, 0x55, 0x22, 0x50, 0x00}, /* 0x26 & */
    {0x00, 0x05, 0x03, 0x00, 0x00, 0x00}, /* 0x27 ' */
    {0x00, 0x1C, 0x22, 0x41, 0x00, 0x00}, /* 0x28 ( */
    {0x00, 0x41, 0x22, 0x1C, 0x00, 0x00}, /* 0x29 ) */
    {0x14, 0x08, 0x3E, 0x08, 0x14, 0x00}, /* 0x2A * */
    {0x08, 0x08, 0x3E, 0x08, 0x08, 0x00}, /* 0x2B + */
    {0x00, 0x50, 0x30, 0x00, 0x00, 0x00}, /* 0x2C , */
    {0x08, 0x08, 0x08, 0x08, 0x08, 0x00}, /* 0x2D - */
    {0x00, 0x60, 0x60, 0x00, 0x00, 0x00}, /* 0x2E . */
    {0x20, 0x10, 0x08, 0x04, 0x02, 0x00}, /* 0x2F / */
    {0x3E, 0x51, 0x49, 0x45, 0x3E, 0x00}, /* 0x30 0 */
    {0x00, 0x42, 0x7F, 0x40, 0x00, 0x00}, /* 0x31 1 */
    {0x42, 0x61, 0x51, 0x49, 0x46, 0x00}, /* 0x32 2 */
    {0x21, 0x41, 0x45, 0x4B, 0x31, 0x00}, /* 0x33 3 */
    {0x18, 0x14, 0x12, 0x7F, 0x10, 0x00}, /* 0x34 4 */
    {0x27, 0x45, 0x45, 0x45, 0x39, 0x00}, /* 0x35 5 */
    {0x3C, 0x4A, 0x49, 0x49, 0x30, 0x00}, /* 0x36 6 */
    {0x01, 0x71, 0x09, 0x05, 0x03, 0x00}, /* 0x37 7 */
    {0x36, 0x49, 0x49, 0x49, 0x36, 0x00}, /* 0x38 8 */
    {0x06, 0x49, 0x49, 0x29, 0x1E, 0x00}, /* 0x39 9 */
    {0x00, 0x36, 0x36, 0x00, 0x00, 0x00}, /* 0x3A : */
    {0x00, 0x56, 0x36, 0x00, 0x00, 0x00}, /* 0x3B ; */
    {0x08, 0x14, 0x22, 0x41, 0x00, 0x00}, /* 0x3C < */
    {0x14, 0x14, 0x14, 0x14, 0x14, 0x00}, /* 0x3D = */
    {0x00, 0x41, 0x22, 0x14, 0x08, 0x00}, /* 0x3E > */
    {0x02, 0x01, 0x51, 0x09, 0x06, 0x00}, /* 0x3F ? */
    {0x32, 0x49, 0x79, 0x41, 0x3E, 0x00}, /* 0x40 @ */
    {0x7E, 0x11, 0x11, 0x11, 0x7E, 0x00}, /* 0x41 A */
    {0x7F, 0x49, 0x49, 0x49, 0x36, 0x00}, /* 0x42 B */
    {0x3E, 0x41, 0x41, 0x41, 0x22, 0x00}, /* 0x43 C */
    {0x7F, 0x41, 0x41, 0x22, 0x1C, 0x00}, /* 0x44 D */
    {0x7F, 0x49, 0x49, 0x49, 0x41, 0x00}, /* 0x45 E */
    {0x7F, 0x09, 0x09, 0x09, 0x01, 0x00}, /* 0x46 F */
    {0x3E, 0x41, 0x49, 0x49, 0x7A, 0x00}, /* 0x47 G */
    {0x7F, 0x08, 0x08, 0x08, 0x7F, 0x00}, /* 0x48 H */
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
};

/* ------------------------------------------------------------------
 * 16×16 大数字字模（'0' ~ '9' + ':'），共 11 字符
 * 每字符 32 字节：先 page0 16 列（上半），再 page1 16 列（下半），LSB 在最上方。
 * ------------------------------------------------------------------ */
static const uint8_t g_font_16x16[][32] = {
    /* '0' */
    {0xE0, 0xF0, 0x38, 0x18, 0x0C, 0x0C, 0x0C, 0x0C, 0x0C, 0x0C, 0x18, 0x38, 0xF0, 0xE0, 0x00, 0x00,
     0x07, 0x0F, 0x1C, 0x18, 0x30, 0x30, 0x30, 0x30, 0x30, 0x30, 0x18, 0x1C, 0x0F, 0x07, 0x00, 0x00},
    /* '1' */
    {0x00, 0x00, 0x10, 0x18, 0x1C, 0xFC, 0xFC, 0x00, 0x00, 0x00, 0x00, 0x00, 0x00, 0x00, 0x00, 0x00,
     0x00, 0x00, 0x30, 0x30, 0x30, 0x3F, 0x3F, 0x30, 0x30, 0x30, 0x30, 0x00, 0x00, 0x00, 0x00, 0x00},
    /* '2' */
    {0x18, 0x1C, 0x0C, 0x0C, 0x0C, 0x0C, 0x0C, 0x0C, 0x0C, 0x8C, 0xFC, 0x78, 0x00, 0x00, 0x00, 0x00,
     0x30, 0x38, 0x3C, 0x36, 0x33, 0x31, 0x30, 0x30, 0x30, 0x30, 0x30, 0x30, 0x00, 0x00, 0x00, 0x00},
    /* '3' */
    {0x18, 0x1C, 0x0C, 0x0C, 0x0C, 0x4C, 0x4C, 0x4C, 0x4C, 0xCC, 0xFC, 0x78, 0x00, 0x00, 0x00, 0x00,
     0x0E, 0x1E, 0x18, 0x30, 0x30, 0x30, 0x30, 0x30, 0x30, 0x18, 0x1F, 0x0F, 0x00, 0x00, 0x00, 0x00},
    /* '4' */
    {0x00, 0x00, 0x80, 0xC0, 0xE0, 0x70, 0x38, 0x1C, 0x0C, 0xFC, 0xFC, 0x00, 0x00, 0x00, 0x00, 0x00,
     0x06, 0x07, 0x06, 0x06, 0x06, 0x06, 0x06, 0x06, 0x06, 0x3F, 0x3F, 0x06, 0x06, 0x00, 0x00, 0x00},
    /* '5' */
    {0xFC, 0xFC, 0x4C, 0x4C, 0x4C, 0x4C, 0x4C, 0x4C, 0x4C, 0xCC, 0x8C, 0x0C, 0x00, 0x00, 0x00, 0x00,
     0x0E, 0x1E, 0x18, 0x30, 0x30, 0x30, 0x30, 0x30, 0x30, 0x18, 0x1F, 0x0F, 0x00, 0x00, 0x00, 0x00},
    /* '6' */
    {0xE0, 0xF0, 0xB8, 0x9C, 0x8C, 0x4C, 0x4C, 0x4C, 0x4C, 0xCC, 0x8C, 0x0C, 0x00, 0x00, 0x00, 0x00,
     0x0F, 0x1F, 0x18, 0x30, 0x30, 0x30, 0x30, 0x30, 0x30, 0x18, 0x1F, 0x0F, 0x00, 0x00, 0x00, 0x00},
    /* '7' */
    {0x0C, 0x0C, 0x0C, 0x0C, 0x0C, 0x0C, 0x0C, 0xCC, 0xEC, 0x7C, 0x1C, 0x0C, 0x00, 0x00, 0x00, 0x00,
     0x00, 0x00, 0x30, 0x3C, 0x3F, 0x07, 0x00, 0x00, 0x00, 0x00, 0x00, 0x00, 0x00, 0x00, 0x00, 0x00},
    /* '8' */
    {0x78, 0xFC, 0xCC, 0x8C, 0x8C, 0x8C, 0x8C, 0x8C, 0x8C, 0xCC, 0xFC, 0x78, 0x00, 0x00, 0x00, 0x00,
     0x0F, 0x1F, 0x18, 0x30, 0x30, 0x30, 0x30, 0x30, 0x30, 0x18, 0x1F, 0x0F, 0x00, 0x00, 0x00, 0x00},
    /* '9' */
    {0x78, 0xFC, 0x8C, 0x8C, 0x8C, 0x8C, 0x8C, 0x8C, 0x8C, 0xCC, 0xFC, 0xF8, 0x00, 0x00, 0x00, 0x00,
     0x00, 0x21, 0x33, 0x33, 0x33, 0x33, 0x33, 0x33, 0x1B, 0x1F, 0x0F, 0x07, 0x00, 0x00, 0x00, 0x00},
    /* ':' */
    {0x00, 0x00, 0x00, 0x00, 0x60, 0xF0, 0xF0, 0x60, 0x00, 0x00, 0x00, 0x00, 0x00, 0x00, 0x00, 0x00,
     0x00, 0x00, 0x00, 0x00, 0x06, 0x0F, 0x0F, 0x06, 0x00, 0x00, 0x00, 0x00, 0x00, 0x00, 0x00, 0x00}
};

#endif /* BSP_OLED_FONT_INTERNAL_H */
