ananantony/flora_mate/(commit log)

2026-05-15 feat: 初版提交
    [STM32F401RCT6开发板-尺寸图.pcbdoc]
2026-05-15 feat: 二次提交，代码编译通过
2026-05-30 feat: 更新到pcb版本
2026-06-08 feat: pcb更新
2026-08-25 feat(hardware): 适配 Top 板双板架构并启用焊板 LED 首测固件
    从 WeAct 单板方案迁移至自研 MCU 最小系统板（FloraMate Top V1.0），
    同步更新原理图、硬件设计文档、CubeMX 配置与生成代码。
    硬件 / 文档：
    - 新增 top板硬件设计方案.md（电源、USB-UART、按键 RC 滤波、I2C、U1 互联）
    - 新增 STM32CubeMX_配置表_V2.0_top板.md（对齐 SCH_Schematic1_2026-08-25.pdf）
    - 归档 Top 板原理图 PDF
    - 记录 I2C2 已知问题：原理图 PB10/PB12，芯片原生 SDA 应为 PB9
    引脚变更（相对 V1.4 WeAct 单板）：
    - 按键 K1~K4：PA6/PA7/PB0/PB1 → PC0~PC3（板载 10k 上拉 + RC 滤波，No pull）
    - 心跳 LED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
    [FloraMate.ioc, main.c, main.h]
2026-08-25 转换为cmake工程
2026-08-28 更新双板方案
2026-08-31 测试 EEPROM 50%
2026-08-31 修复led配置
2026-09-10 feat(hmi): 实现 V2.0 产品交互路径并更新文档
    将上电流程改为 Logo → Idle → 主界面/自动浇水，重做菜单与显示层，并同步 HMI 设计与测试文档；清理中间产物并更新 .gitignore。
2026-09-13 feat: 更新
